UndDo87077/self-balancing-robot-V2/Electric/ODrive_config/ODrive_S1_configuration.md

# Anleitung: Konfiguration der ODrive S1 Shields

> **Anmerkung**  
>Als Isolation zwischen den Motorschilden und dem Roboterchassis wird aktuell nur Papier genutzt und müsste bevor die Motoren höher bestromt werden durch einen passenden Isolator getauscht werden

---

## 1. Übersicht

In dieser Anleitung wird Beschrieben wie die Odrive Motorschilde konifguriert werden und auf was dabei zu achten ist.

### Verwendete Hardware

| Komponente | Beschreibung |
|---|---|
| ODrive S1 | Motorcontroller |
| Motor | M8325s-100KV |
| Spannungsversorgung | Akku, 24-28 V |
| Steuergerät | Teensy|
| Verbindung |  UART |

### Verwendete Software

| Software | |
|---|---|
| ODrive GUI | Konfiguration und Diagnose |
| Firmware | 0.6.12 |

---

## 2. Anschluss des ODrive S1

Die beiden Odrive S1 Controller sind via UART mit dem Teensy 4.0 verbunden. Für die beiden Verbindungen werden als Serial1 Pin 0,1 und Serial2 Pin 7,8 verwendet. Hier ist anzumerken, dass es bei der Verwendung von Wago-Klemmen zu Problemen kommen kann. Der Verbindungsaufbau via UART hat beim verwenden von zwei Kammern der Klemme nicht funktioniert während das pressen beider Verbindungskabel in eine Kammer die Verbindung ermöglicht. 

---

## 3. Verbindung mit der ODrive GUI

1. Verbindung via USB-Kabel herstellen
2. ODrive GUI öffnen. (https://gui.odriverobotics.com/configuration, am besten Microsoft Edge)
3. Prüfen, ob das Board erkannt wird

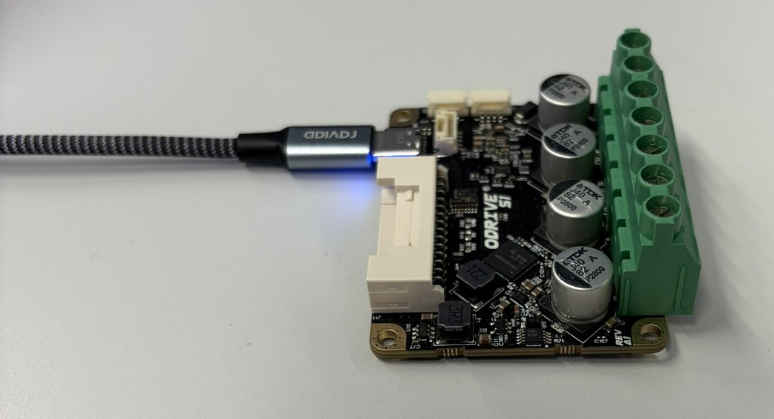
[picture p3: Electric/ODrive_config/images/ODrive.JPEG]
Screenshot: ODrive erkannt


## 4. Konfiguration
Wenn der Odrive Ordnungsgemäß angeschlossen und in der GUI erkannt wird hat man anschließend die Möglichkeit den ODrive zu Konfigurieren. 

---
### 4.1 Power Source

Hier sind die Spannungsgrenzen der Versorgung einzustellen, die Überspannungsgrenze wird auf 48- und die Unterspannungsgrenze auf 20 Volt gestellt.

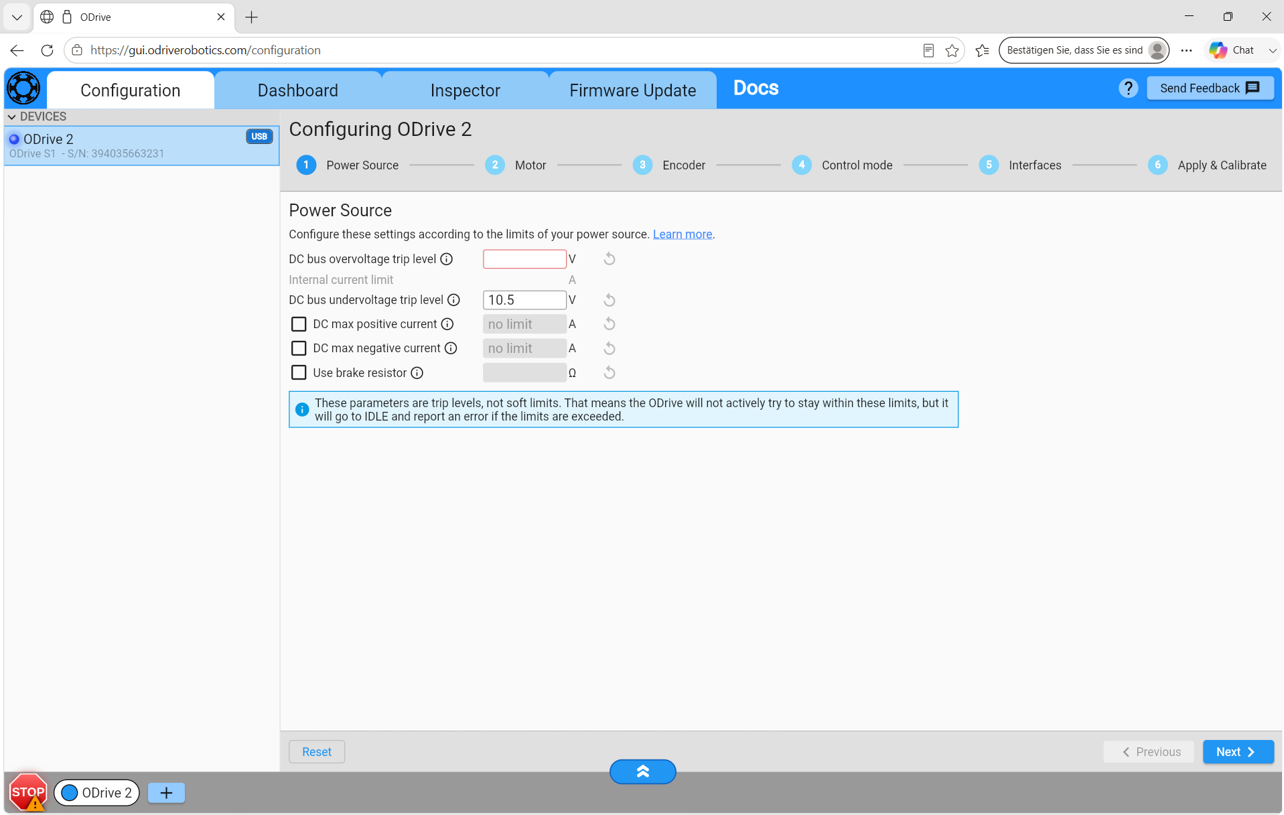
[picture p4: Electric/ODrive_config/images/Power_source.png]
Screenshot: Power Source


---
### 4.2 Motor

Bitte den M8325s-100KV auswählen, die voreingestellten Werte könne behalten werden, einzig "Use Thermistor" muss deaktiviert werden.

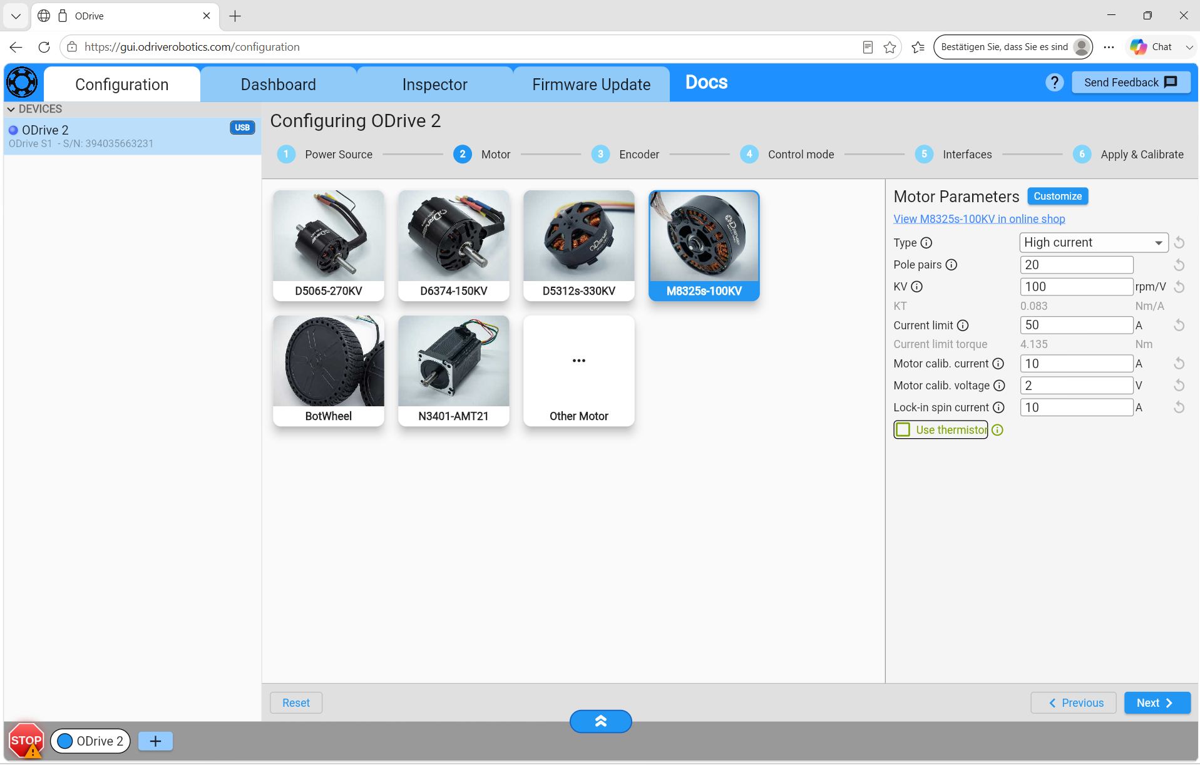
[picture p5: Electric/ODrive_config/images/Motor.png]
Screenshot: Motor


---
### 4.3 Encoder

Als Encoder verwendet Roboter den Onboard Encoder der Odrives. Wichtig zu beachten ist, dass das Motorschild so nah wie möglich an dem Motor installiert werden muss, dass dieser nicht durch die Motorströme gestört wird.

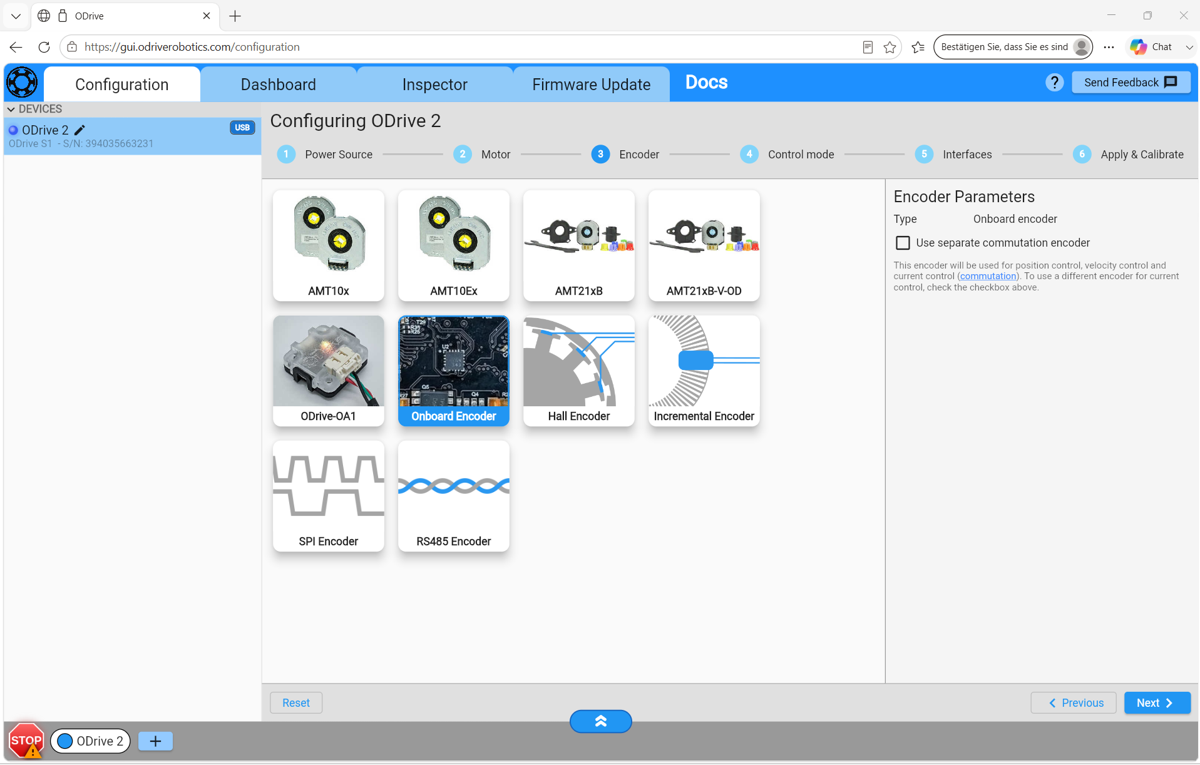
[picture p6: Electric/ODrive_config/images/Encoder.png]
Screenshot: Encoder


---

### 4.4 Control Mode

Der Control Mode muss von Velocity- auf Torque Control geändert werden.

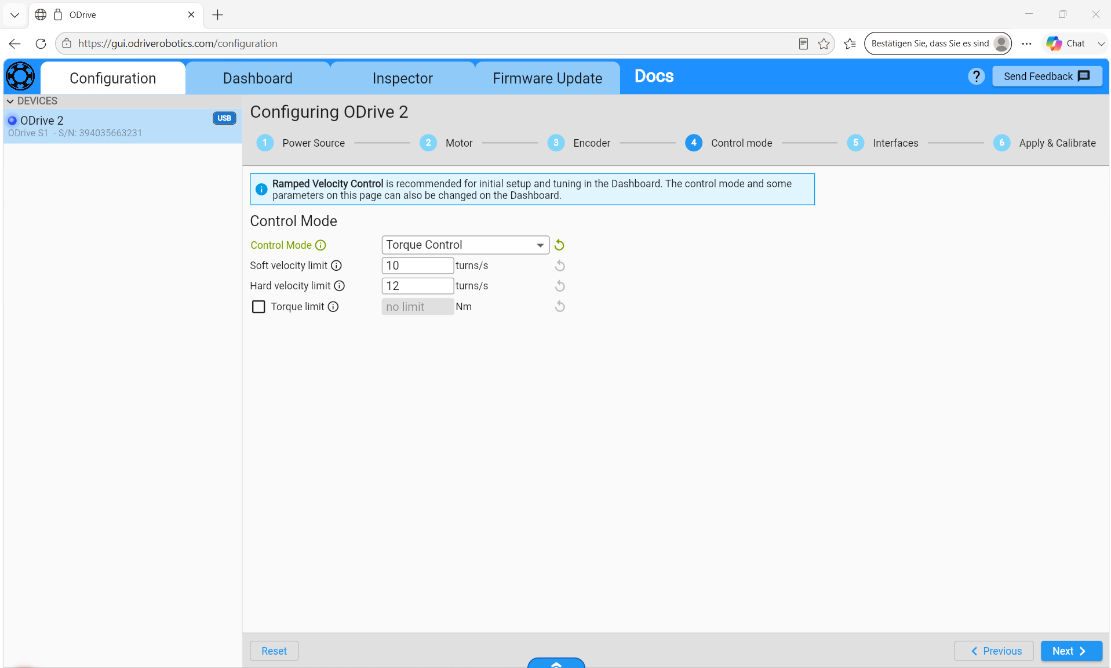
[picture p7: Electric/ODrive_config/images/Control_Mode.png]
Screenshot: Control Mode


---

### 4.5 Interfaces

Hier wird die verwendete Kommunikationsart zwischen Teensy und Odrive festgelegt. Die Voreinstellung CAN Bus kann deaktiviert und dafür UART aktiviert werden. Hierbei bitte drauf achten, dass als Baudrate 115200 bits/s

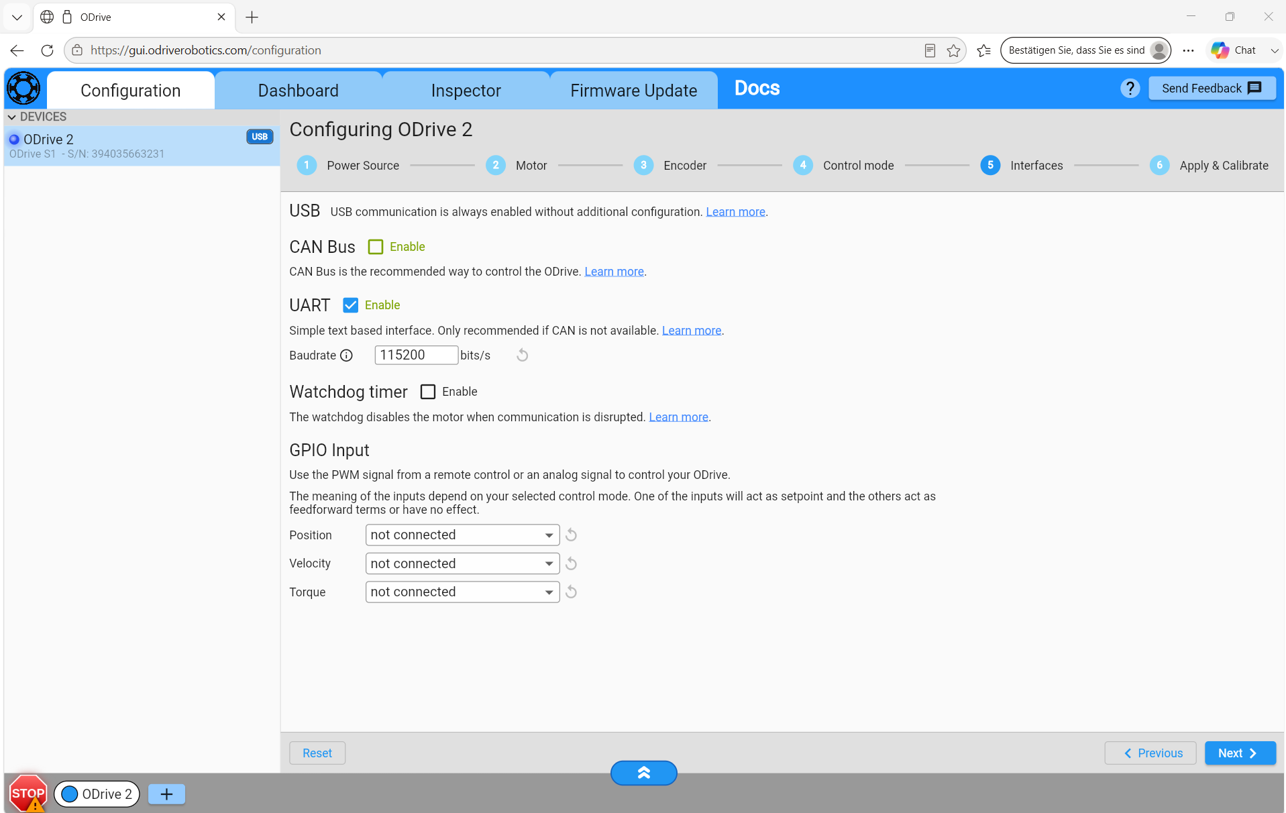
[picture p8: Electric/ODrive_config/images/Interface.png]
Screenshot: Interfaces


---

### 4.6 Apply & Calibrate

Einfach von Oben nach Unten durcharbeiten, manchmal muss die Kalibrierung ein zweites mal gestartet werden um Orndungsgemäß durchzulaufen.

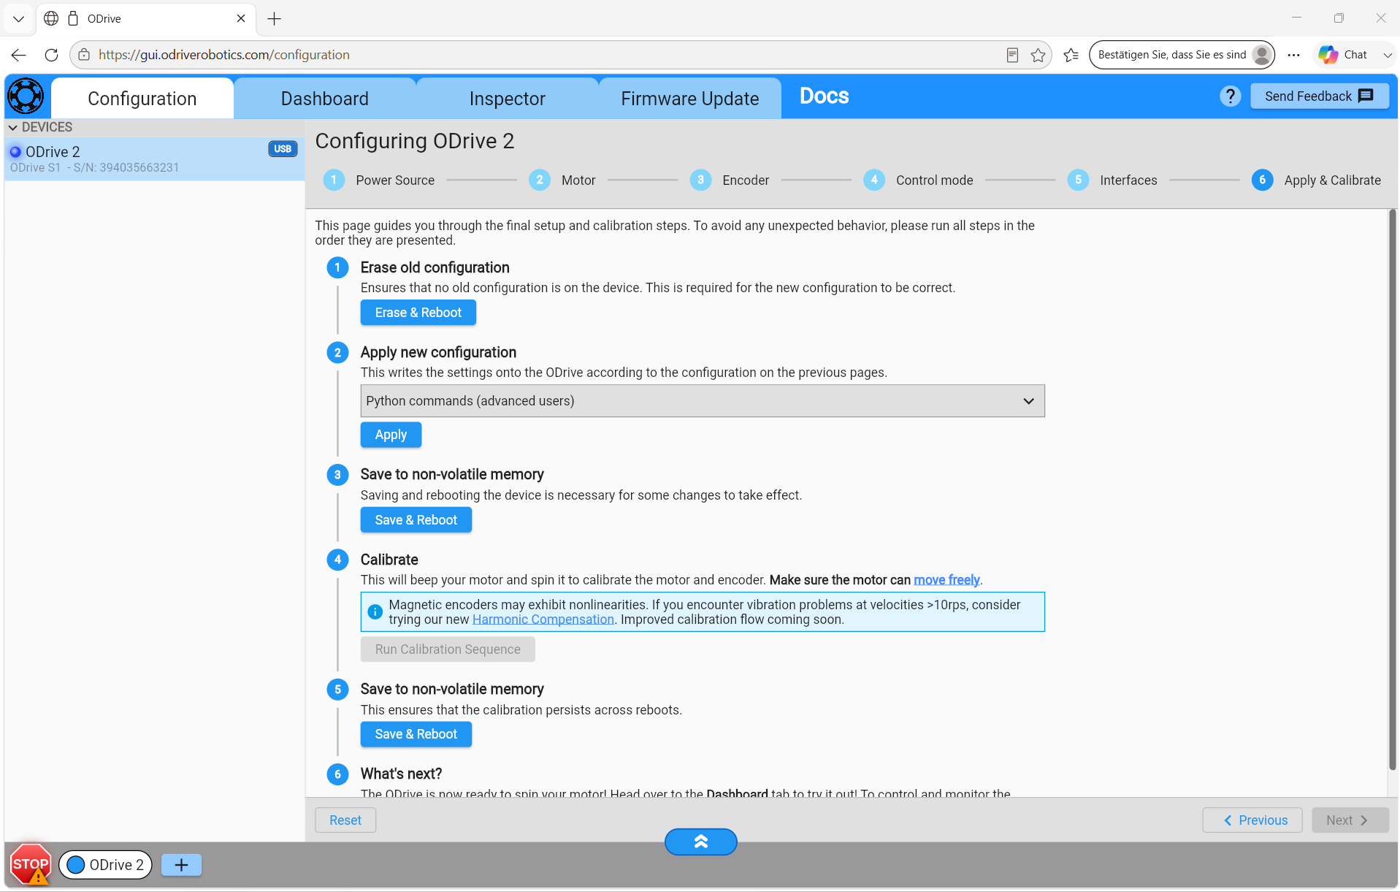
[picture p9: Electric/ODrive_config/images/Apply_and_Calibrate.png]
Screenshot: Apply & Calibrate


---
## 5. Weitere Masken

### 5.1 Dashboard
Unter Dashboard ist eine einfache Signalmonitor der wichtigsten Größen des Motorschildes zu sehen. Über die Start und Stop Taste kann ein gewünschter Ausschnitt angeschaut werden, im Zeitverlauf umherscrollen ist nicht möglich.

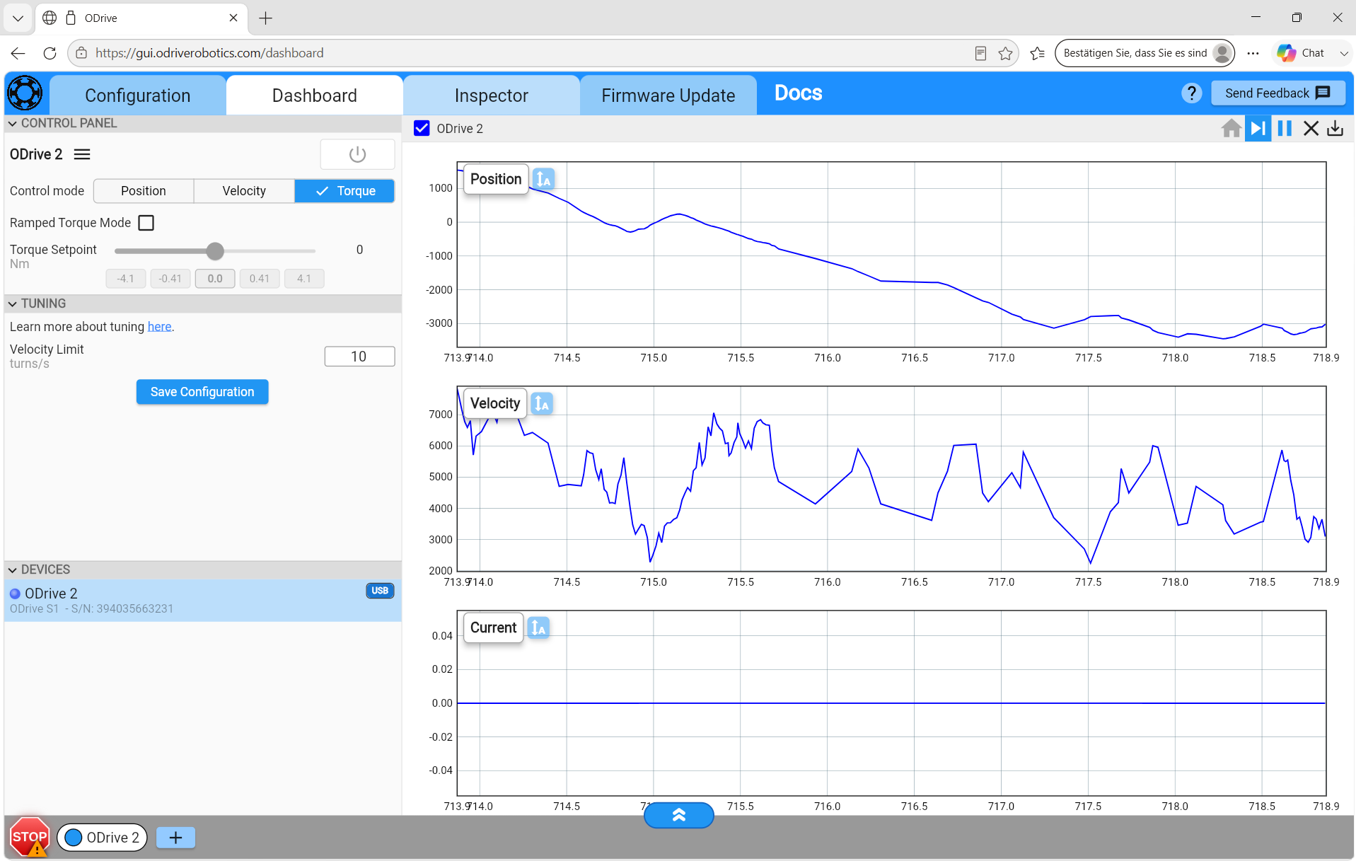
[picture p10: Electric/ODrive_config/images/Dashboard.png]
Screenshot: Dashboard


### 5.2 Inspector
Im Inspector können alle Werte/Parameter des Odrives verändert beziehungswiese eingesehen werden. 

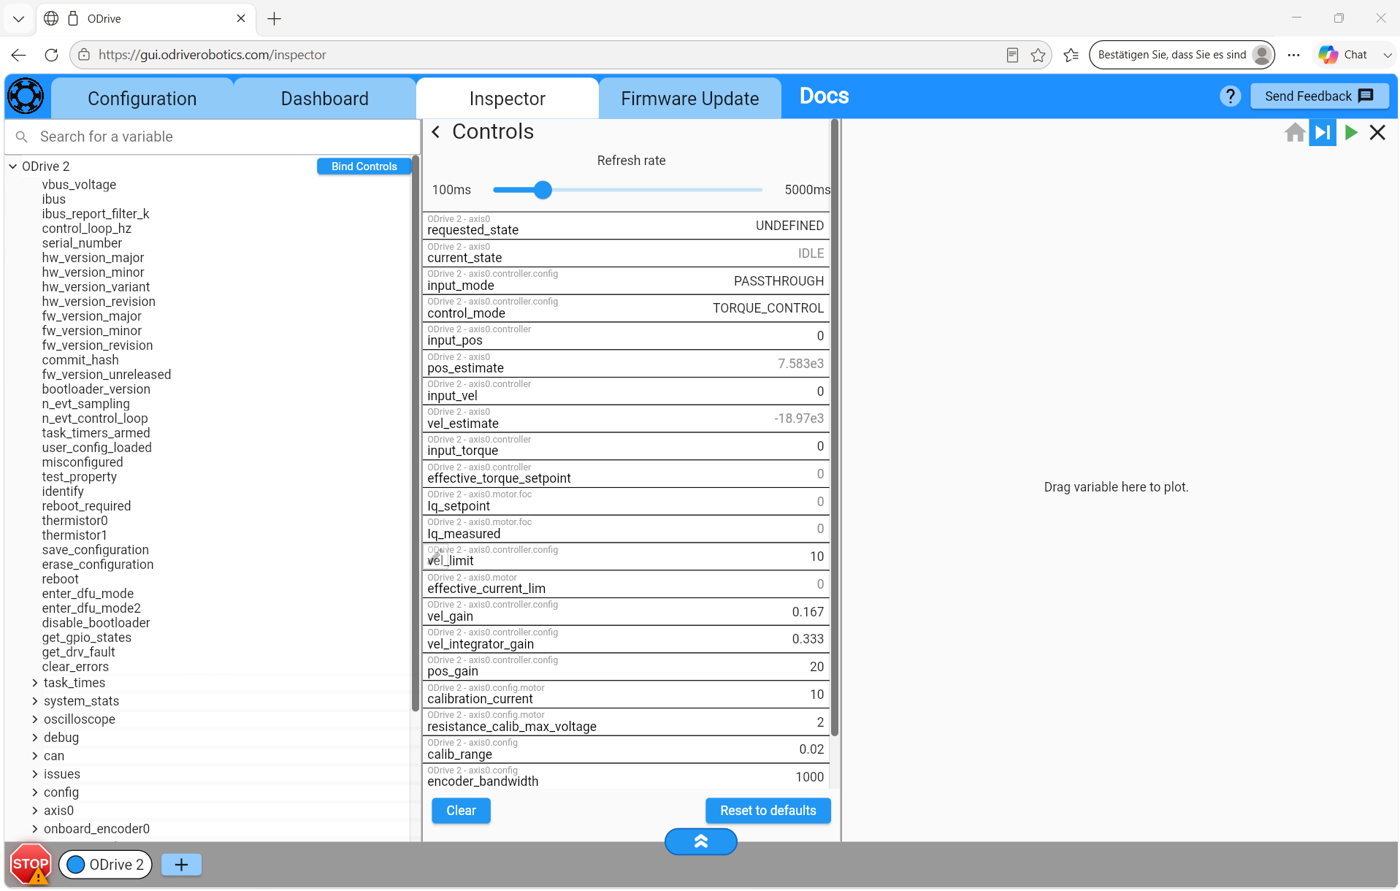
[picture p11: Electric/ODrive_config/images/Inspector.png]
Screenshot: Inspector


---
