UndDo87077/self-balancing-robot-V2/Electric/Circuit_Board_Modular_positioning.pdf

X1:1 24V
X1:2 GND

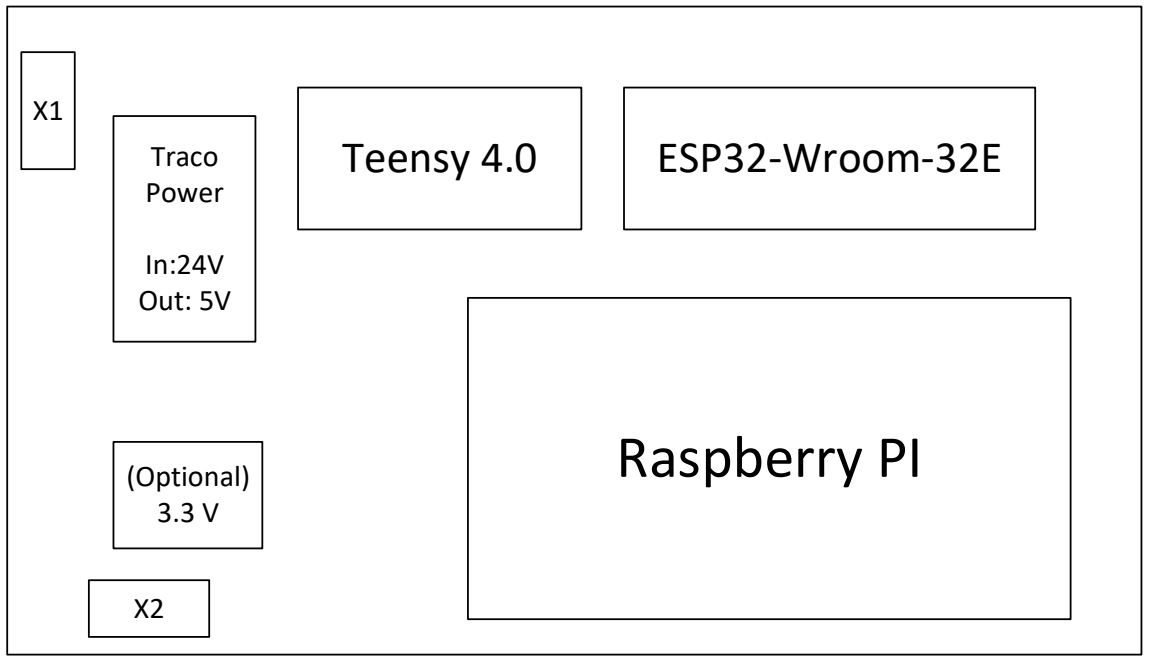
[picture p12: figure]
Traco Power; In:24V Out: 5V; Raspberry PI; (Optional) 3.3 V; Teensy 4.0; ESP32-Wroom-32E

X2:1 | X2.2
3.3V | Isolated GND

USB-Ports
USB 2.0 – connected to ESP32 (MicroRos) USB 3.0 – connected to Lidar
USB 3.0 connected to Alfa Network Adapter

Note:
Traco Power output is galvanically isolated
