UndDo87077/self-balancing-robot-V2/Electric/Electrical_Documentation.pdf

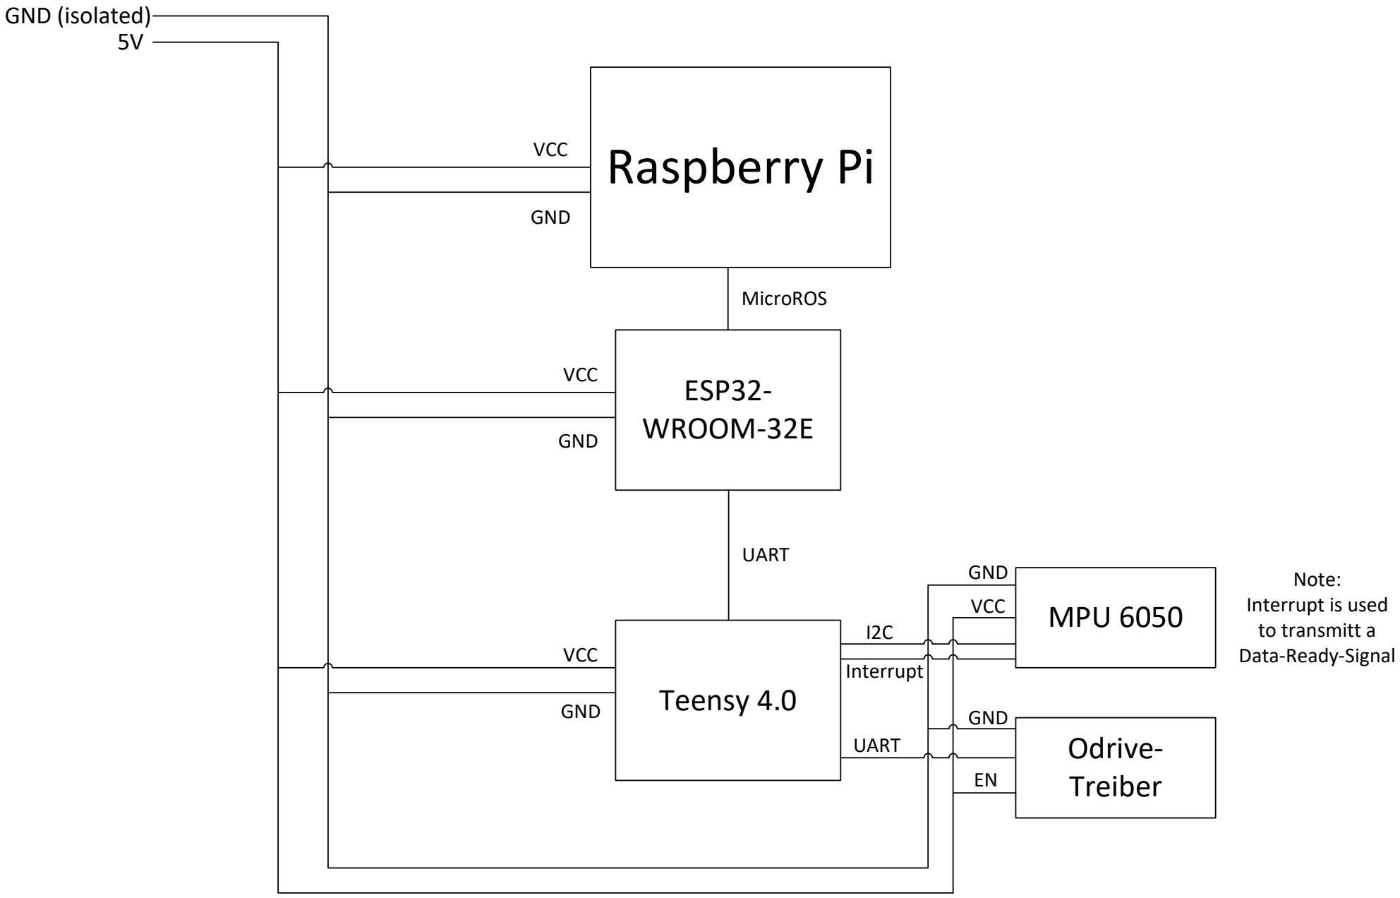
[picture p13: figure]
Raspberry Pi; ESP32- WROOM-32E; Teensy 4.0; MPU 6050; Odrive- Treiber; VCC; GND; GND (isolated); MicroROS; UART; Interrupt; Note: Interrupt is used to transmitt a Data-Ready-Signal
