UndDo87077/self-balancing-robot-V2/Electric/PCB_Roboter_Charger.png

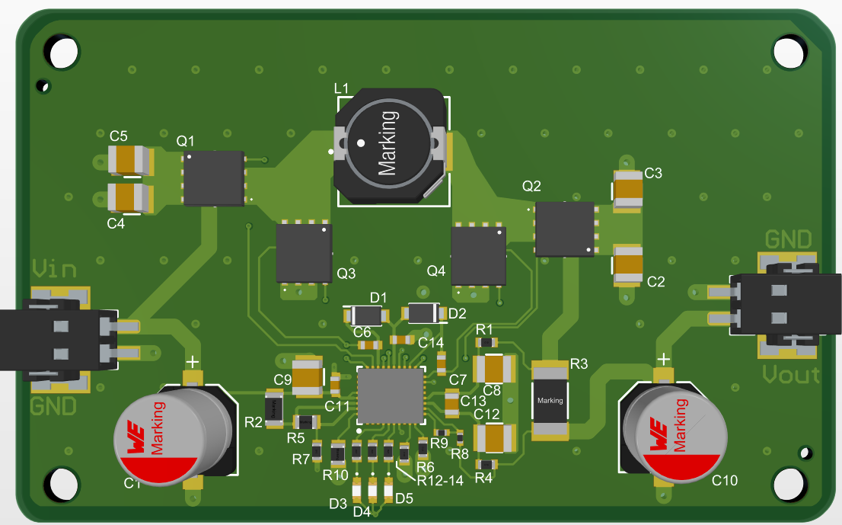
Electric/PCB_Roboter_Charger.png
