UndDo87077/self-balancing-robot-V2/Electric/Schematic Roboter_Charger.png

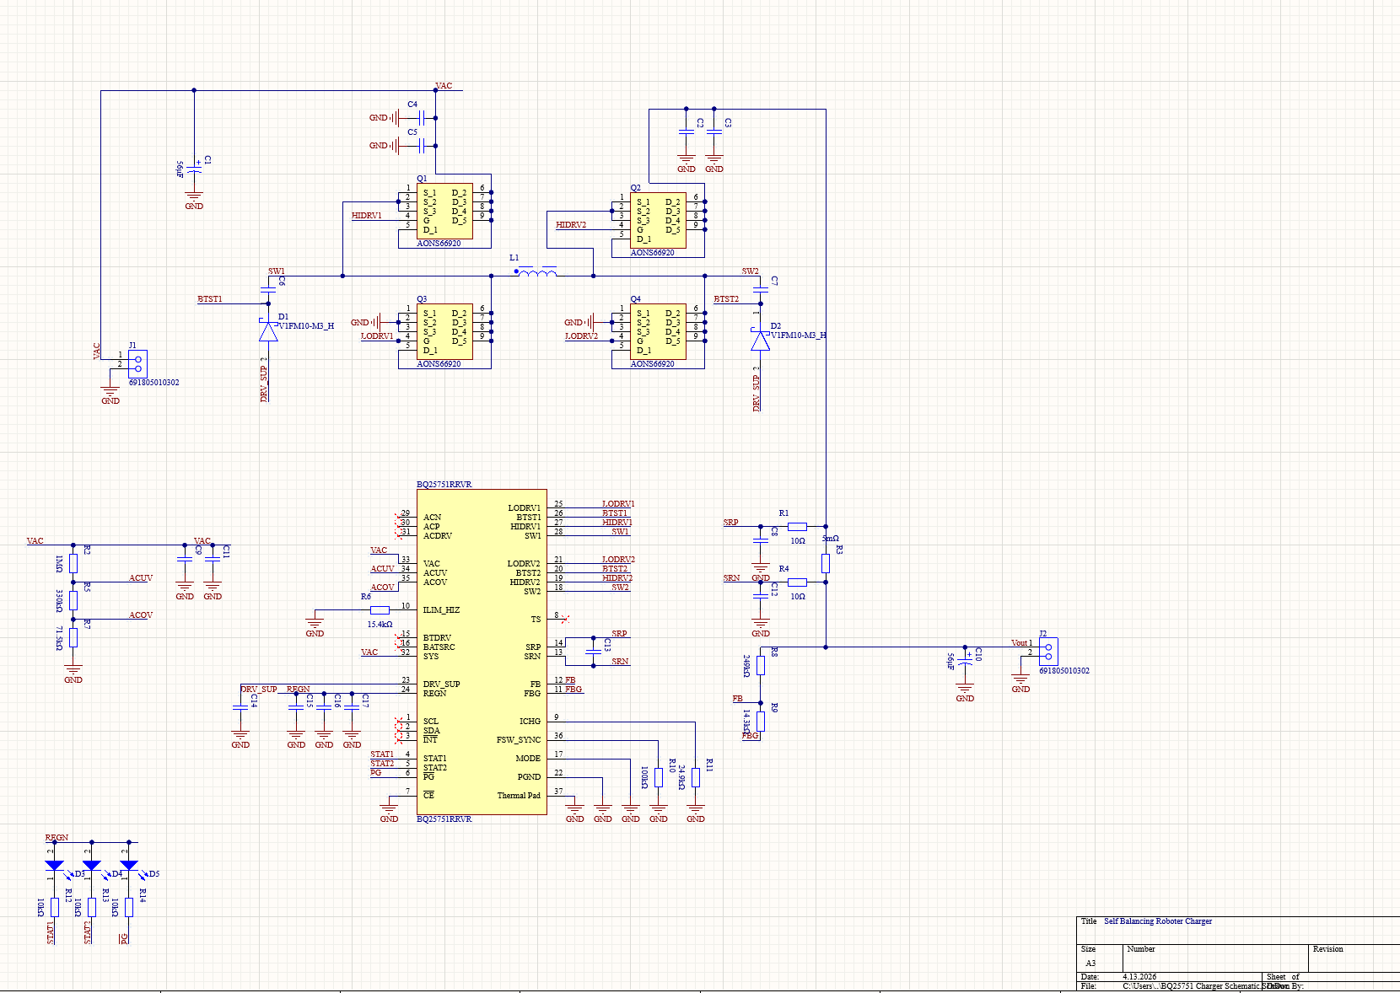
Electric/Schematic Roboter_Charger.png
