UndDo87077/self-balancing-robot-V2/Electric/Wireless_Notaus.png

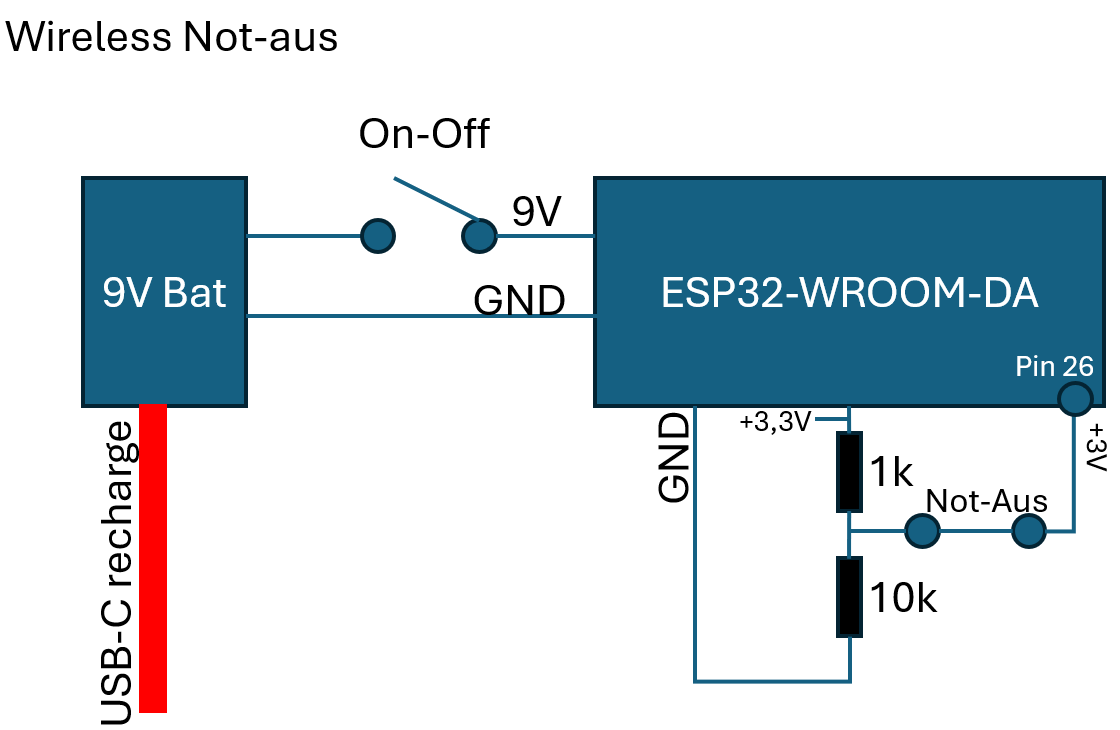
Electric/Wireless_Notaus.png
