UndDo87077/self-balancing-robot-V2/Images/Final_Robot_2.PNG

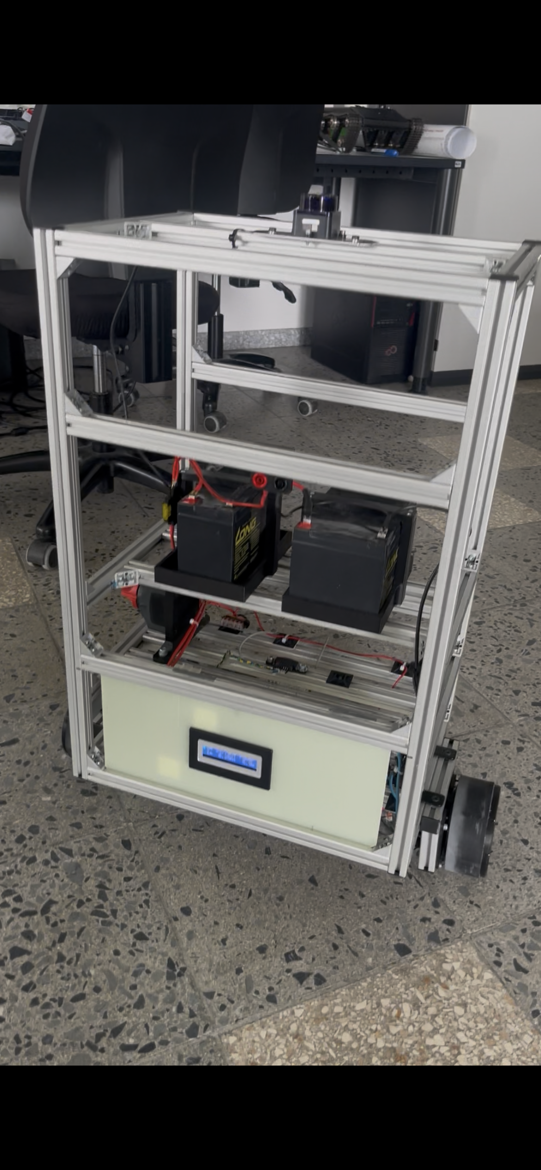
Images/Final_Robot_2.PNG
