UndDo87077/self-balancing-robot-V2/(commit log)

2026-02-15 Add files via upload
    Updated Electrical Circuit and Module positioning on the new circuit board
2026-02-15 Add files via upload
    Upgraded DC-DC Converter with Isolated GND-Potential
2026-04-13 Add files via upload
    Teensy Code
2026-04-13 Add files via upload
    Ros2 Files on Raspberry Pi
2026-07-05 Add files via upload
    outdated
    Beinhaltet ältere Version des Zustandsreglers
2026-07-05 Add files via upload
    Erste Version des PID-Codes- Fehlerhafter Regler
    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
2026-07-05 Add files via upload
    ESP32 Code mit integrierten Microros-Schnittstelle;
    1 Kern Microros ; 1 Kern Uart zu Teensy
